xxiaolove8/engineering_innovation/docs/2026929PINOUT.md

# STM32F407 小车 PINOUT V3.1（同学验收版）

日期：2026-09-29。用途：载板原理图、PCB数字焊盘、线束和软件配置共用基线。

冻结范围：本版24根信号及接口数字脚号。**接线复核通过，不等于整机电气、机械或投板验收通过。** 任何后续改线须同步更新本文件与软件。

## 0. 工程版本、已确认项与边界

本版对应用户上传的 `NEWESTProPrj_工创分散实训小车主控板_2026-09-29.epro2`，大小252161字节，工程编辑器版本4.1.60。

SHA256：`523AC0C17B9F0D428ABD6AA84F86723254952C9E43B3041C24CF4AD324DDE7A5`。

已独立读取该工程的符号、数字引脚、封装、导线和网络属性：24根信号端点均与本表一致；23个实际元件的数字引脚集合与关联封装焊盘集合匹配；主要电源网未发现意外合并。这是源数据复核，不是由助手重新运行EDA内置DRC。详情见《最新工程审核_2026-09-29.md》。

用户提供的23:09:28 DRC为：致命错误0、错误0、警告8。此后仅口头说明“改好了”的修改不自动算作已审核；验收时应以新导出的工程和DRC记录为准。

本版确认：

- GRAY_OUT已从PF3 / H1-46改到PC5 / H1-16；旧PF3端点已标不连接，不是待实施建议。
- H1-3 / RESET没有接地，并标不连接。
- GPIO功能放在“引脚名称”，数字1、2……放在“引脚编号”，与PCB焊盘一致。网络名称仍由实际导线/网络标签定义，不能只靠普通文字。
- 蓝牙PB10=H2-28、PB11=H2-29。不得沿用旧稿错误的26/27号。
- 三路Echo维持直连，不把10kΩ/15kΩ分压或灰度转换芯片列为强制新增器件；电平条件见第5节。
- 现有入口10µF不等于舵机储能设计已验收；详细待办见《待研究与同学验收清单.md》。

可以进入PCB初步布局；在电源预算、接口实物方向等关键条件未确认前，不作为投板批准。V3.0原文留存在work目录；旧接线步骤只用于追溯，当前接线以本文件为准。

## 1. 依据和约定

1. 主控连线/排针号唯一依据：用户《ATK-DNM144Z-M4 STM32F407版_V1.0.pdf》，STM32F407ZGT6，M144Z-M4.PrjPCB V1.0。第1页核对PC5，第2页核对JP1/JP2、SRAM、Camera，第3页核对USB/电源。
2. GPIO复用/电气：ST DS8626。该手册不能代替实际核心板排针图。
3. 灰度：用户ZIP中的《8路灰度模块简介》《数据读取》《小车巡线》。数字扫描成立，但资料没有完整VOH/VOL/VIH/VIL保证表。
4. 超声波：用户《超声波模块手册HC-SR04-P…pdf》。实物须对应此型号；手册照片本身也只印HC-SR04，不能仅凭正面丝印区分版本。
5. D24A：用户两张商品接口/尺寸图；四路TB6612带稳压，只用A/B。J7数字针号是载板定义，不是商品图中的厂家针号。
6. ROS参考板：仅借鉴电源分区、去耦、接口整理；它是F103裸芯片设计，不用于决定本板引脚。其R4/R5属于PWRADC电源采样，不是Echo分压。

H1对应官方JP1，H2对应JP2。表格是符号/焊盘编号，不是实物某一面目视左右。A电机暂定左，B电机暂定右，安装/调试确认正方向。

## 2. 主控24根信号表（已按上传工程核对）

方向以MCU为准；O=输出，I=输入。A电机暂定左，B电机暂定右；实际转向和编码器正负号由调试确认。

| 功能 | 网络标签 | GPIO | 载板脚号 | 软件功能 | 方向 | 外设端点 |
|---|---|---|---|---|---|---|
| 左电机PWM | DRV_PWMA | PA2 | H1-8 | TIM5_CH3 / AF2 | O | J7-4 / PWMA |
| 右电机PWM | DRV_PWMB | PA3 | H1-9 | TIM5_CH4 / AF2 | O | J7-3 / PWMB |
| 左方向1 | DRV_AIN1 | PC0 | H2-15 | GPIO Output | O | J7-8 / AIN1 |
| 左方向2 | DRV_AIN2 | PC1 | H2-16 | GPIO Output | O | J7-6 / AIN2 |
| 右方向1 | DRV_BIN1 | PC2 | H1-10 | GPIO Output | O | J7-7 / BIN1 |
| 右方向2 | DRV_BIN2 | PC3 | H1-7 | GPIO Output | O | J7-5 / BIN2 |
| 驱动使能 | DRV_STBY | PC4 | H1-13 | GPIO Output，初始化低 | O | J7-2 / STBY |
| 左编码器A相 | ENC_L_A | PC6 | H2-50 | TIM3_CH1 / AF2 | I | J7-10 / E1A |
| 左编码器B相 | ENC_L_B | PC7 | H2-49 | TIM3_CH2 / AF2 | I | J7-12 / E1B |
| 右编码器A相 | ENC_R_A | PB6 | H2-32 | TIM4_CH1 / AF2 | I | J7-9 / E2A |
| 右编码器B相 | ENC_R_B | PB7 | H2-19 | TIM4_CH2 / AF2 | I | J7-11 / E2B |
| 舵机PWM | SERVO_PWM | PE9 | H1-36 | TIM1_CH1 / AF1 | O | J1-3 / PWM |
| 蓝牙发送 | UART3_TX | PB10 | H2-28 | USART3_TX / AF7 | O | J3-2 / 模块RX |
| 蓝牙接收 | UART3_RX | PB11 | H2-29 | USART3_RX / AF7 | I | J3-3 / 模块TX |
| 灰度地址最低位 | GRAY_AD0 | PF0 | H1-47 | GPIO Output | O | J2-3 / AD0 |
| 灰度地址中间位 | GRAY_AD1 | PF1 | H1-48 | GPIO Output | O | J2-4 / AD1 |
| 灰度地址最高位 | GRAY_AD2 | PF2 | H1-45 | GPIO Output | O | J2-5 / AD2 |
| 灰度数字输入 | GRAY_OUT | PC5 | H1-16 | GPIO Input / No Pull，不用ADC | I | J2-2 / OUT，直连 |
| 左超声波触发 | US_L_TRIG | PA1 | H1-5 | GPIO Output，初始化低 | O | J4-2 / TRIG |
| 左超声波回波 | US_L_ECHO | PF6 | H1-21 | TIM10_CH1 / AF3 / No Pull | I | J4-3 / ECHO，直连 |
| 中超声波触发 | US_C_TRIG | PA5 | H1-11 | GPIO Output，初始化低 | O | J5-2 / TRIG |
| 中超声波回波 | US_C_ECHO | PF7 | H1-22 | TIM11_CH1 / AF3 / No Pull | I | J5-3 / ECHO，直连 |
| 右超声波触发 | US_R_TRIG | PA7 | H1-14 | GPIO Output，初始化低 | O | J6-2 / TRIG |
| 右超声波回波 | US_R_ECHO | PF8 | H1-19 | TIM13_CH1 / AF9 / No Pull | I | J6-3 / ECHO，直连 |

PC5只作数字输入，不同时启用ADC12_IN15/ETH。已核对GRAY_OUT只连接H1-16与J2-2，H1-46不在该网络。数字脚号属于载板连接器，不是STM32芯片封装管脚号。

## 3. 电源、复位、保留脚及板载资源

| 脚号 | 官方定义 | 本设计接法 |
|---|---|---|
| H1-1 | GND | 公共地 |
| H1-2、H1-4 | VCC3.3 | 载板+3.3V，来自核心板，不并联D24A另一3.3V输出 |
| H1-3 | RESET | 已与GND断开，当前载板端点标不连接 |
| H1-6 | VREF | 保留不接，不当普通供电脚 |
| H1-46 | PF3 / SRAM A3 | 已不接灰度OUT，载板端点标不连接 |
| H2-1、H2-3 | VCC5 | 载板+5V |
| H2-2、H2-4 | GND | 公共地 |
| H2-5 | VBAT | 当前不接 |
| H2-20 | PG10 / SRAM CE | 载板不外接；软件确保核心板SRAM未选中 |

板载SRAM U2=XM8A51216V33A，3.3V供电。官方R1=10kΩ上拉CE；PE9共用D6，PF0/PF1/PF2共用A0/A1/A2。软件不启用FSMC/外部SRAM，先确保PG10高，再配置舵机与灰度。不插LCD。

OUT改PC5是为了避开PF3/SRAM A3共线。缺少模块OUT与SRAM输入耐压保证时，不能仅凭MCU的FT标记给整个共用网络验收；不声称已经证明原PF3一定损坏。

PC6/PC7/PB6/PB7还引到Camera：不插摄像头/其他外部驱动模块，不启用DCMI。其余板载Flash/TF/LED等资源脚不新增为本版信号。PA0未引到这两个50针接口，不占用。

## 4. 全部外设连接器

### J7：D24A A/B控制、编码器，2×6

| J7脚号 | 功能 | 网络 |
|---:|---|---|
| 1 | 3V3 | 不接，避免并联稳压输出 |
| 2 | STBY | DRV_STBY |
| 3 | PWMB | DRV_PWMB |
| 4 | PWMA | DRV_PWMA |
| 5 | BIN2 | DRV_BIN2 |
| 6 | AIN2 | DRV_AIN2 |
| 7 | BIN1 | DRV_BIN1 |
| 8 | AIN1 | DRV_AIN1 |
| 9 | E2A | ENC_R_A |
| 10 | E1A | ENC_L_A |
| 11 | E2B | ENC_R_B |
| 12 | E1B | ENC_L_B |

商品图元件面朝上、开关在上，六行左/右依次为3V3/STBY、PWMB/PWMA、BIN2/AIN2、BIN1/AIN1、E2A/E1A、E2B/E1B。插接面方向另核对，不能把焊接面左右当元件面左右。

J8-1/2均为GND，通过实际线束共地；J7没有GND，不能省略实际地回路。电机接D24A Motor A/B匹配的六针接口，C/D不用。

### J1、J2、J3

| 接口 | 数字脚号与定义 |
|---|---|
| J1舵机 | 1=GND；2=+5V；3=SERVO_PWM |
| J2灰度 | 1=GND；2=GRAY_OUT；3=GRAY_AD0；4=GRAY_AD1；5=GRAY_AD2；6=+5V |
| J3六针蓝牙底板 | 1=STATE不接；2=RX接UART3_TX；3=TX接UART3_RX；4=GND；5=+5V；6=3V3不接 |

J3的5V只适用于确认支持5V供电的六针底板，不能用于裸模块。J1供电和峰值电流按实际舵机规格确认。

### J4、J5、J6：本版维持当前5V供电/直连

| 脚号 | J4左 | J5中 | J6右 |
|---:|---|---|---|
| 1 | +5V | +5V | +5V |
| 2 | US_L_TRIG | US_C_TRIG | US_R_TRIG |
| 3 | US_L_ECHO | US_C_ECHO | US_R_ECHO |
| 4 | GND | GND | GND |

不需要RAW标签或旧六只分压电阻。不擅自改供电为3.3V。若以后选P版3.3V供电，须同步改电源线、符号脚名/丝印与去耦电源网，不是只改文字；GPIO仍不变。

### 电源和备用驱动

- J13 POWER_IN：1=+5V，2=GND，是稳压后5V输入，不接电池原电压。
- J14 MOTOR_PWR_IN：1=5V_MOTOR，2=GND；只通备用TB6612 VM，不是D24A Vin/降压模块。
- J9：1=VM/5V_MOTOR；2=VCC/+3.3V；3=GND；4=AO1/MOTORLA；5=AO2/MOTORLB；6=BO2/MOTORRB；7=BO1/MOTORRA；8=GND。
- J10：1=DRV_PWMA；2=DRV_AIN2；3=DRV_AIN1；4=DRV_STBY；5=DRV_BIN1；6=DRV_BIN2；7=DRV_PWMB；8=GND。
- J11：1=MOTORLA，2=MOTORLB；J12：1=MOTORRA，2=MOTORRB。

本版保留备用接口，不擅自删图；默认只用D24A，备用TB6612模块未插、J14未供电。两个驱动不接同一电机；切换先断电。不要长期插着备用模块却不给它供电，以免控制线经其内部路径反供电。

## 5. 电平依据及验收

### Echo

P版手册允许3.0~5.5V供电，但未给5V供电时Echo VOH/VOL、Trig VIH/VIL。不能认定Echo必为5V或必为3.3V，低压直连说明也不等于5V供电时固定3.3V输出。

PF6/7/8在ST表7均为FT。核心板正常3.3V供电、数字/定时器输入、No Pull、不启用模拟功能且满足ST数据手册条件时，可接收符合条件的3.3V或5V数字电平，因此本版不强制分压。ST DS8626表14在VDD为2.0～3.6V时给出FT输入工作范围−0.3～5.5V，并要求输入高于VDD+0.3V时禁用内部上/下拉；设计不能把边界值当作过冲余量。调试核验Echo高低电平/过冲及3.3V Trig触发可靠性，不把万用表脉冲平均值当峰值。

若原Echo为3.3V，旧10k/15k会降到1.98V，缩小高电平余量。FT不是噪声、掉电或接错线的全面保护；外设不得独立上电后持续向掉电核心板送信号，不带电插拔。

### 灰度

模块按手册供5V；AD0/1/2选择CD4051通道，OUT数字输出，EN已有10kΩ下拉。配套F103教程用3.3V推挽输出PA0/1/2直接驱动地址、PA3直接读OUT；配套小车教程也是5V模块与STM32直接接线。这是供应商应用依据，不是完整最坏条件保证表。

本版PF0/1/2直接输出地址，PC5 FT数字输入/No Pull读取OUT。不要在地址线上分压；不默认增加升压或输出缓冲芯片；不用ADC。

AD2 AD1 AD0：000→CH1，001→CH2，…，111→CH8；切换后按例程先等待50µs。黑白对应按实物校验。核对实际CD4051门限与3.3V地址输出裕量，并实测全部8通道选通和OUT电平；依据规格与测试决定是否需要转换，不盲加器件，也不把单次试通当作最坏条件保证。

## 6. 定时器、软件约束

| 用途 | 资源 | 约束 |
|---|---|---|
| 电机两路PWM | TIM5 CH3/CH4 / AF2 | 同频，占空比独立 |
| 左编码器 | TIM3 CH1/CH2 / AF2 | 编码器模式 |
| 右编码器 | TIM4 CH1/CH2 / AF2 | 编码器模式 |
| 舵机 | TIM1 CH1 / AF1 | 周期/脉宽按实物，不直接冻结50Hz |
| 左/中/右Echo | TIM10 CH1 AF3 / TIM11 CH1 AF3 / TIM13 CH1 AF9 | 单通道16位捕获，边沿配对、超时和回绕 |
| 蓝牙 | USART3 / AF7 | 波特率按模块 |
| 灰度 | PF0/1/2输出，PC5输入 | 数字扫描 |

TIM10与TIM1更新共享TIM1_UP_TIM10；TIM11与TIM1触发/换相共享TIM1_TRG_COM_TIM11；TIM13与TIM8更新共享TIM8_UP_TIM13。中断内区分事件，不照搬双通道PWM Input例程。分频依据真实APB定时器时钟。三路探头轮流触发，不同时发射。

先确保PG10高、FSMC/DCMI不用；STBY/TRIG保持低；配置方向/PWM/捕获/UART/灰度，再按需使能电机。GRAY_OUT使用GPIOC Pin5并开启GPIOC时钟，逻辑名保持不变。复位/程序下载期间STBY是否可靠为低仍须核对D24A板上的上下拉与硬件默认状态，不能只靠程序运行后拉低。

## 7. 电源、现有电容与验收状态

电池→D24A Vin；D24A 5V/GND→J13→载板+5V/GND→核心板/5V外设。电池匹配电机与模块额定范围；商品输入5.5～15V、输出5V 5A只是商品标称，不是实际峰值能力和热余量测试结论。

核心板USB_5V经F1直接连VCC5，未画电源择一路径；保险丝不隔离回灌。当前普通USB供电与外部5V二选一。外供电下使用SWD时，确认调试器不另外输出供电；Vref检测脚和电源输出脚不能混淆。若要USB和外部电源同时连接，必须另行审核真实电源会合路径。

### 已上传工程实际放置的7只电容

| 位号 | 容量与型号 | 电源与位置用途 |
|---|---|---|
| C1 | 100nF，GCM31C5C1H104FA16L，1206 / 50V / C0G | J13入口去耦，跨+5V与GND |
| C2 | 同上，100nF | 灰度J2供电去耦 |
| C3 | 同上，100nF | 蓝牙J3供电去耦 |
| C7、C9、C10 | 同上，各100nF | 三路超声波J4/J5/J6供电去耦 |
| C12 | 10µF，CL21A106KAYNNNE，0805 / 25V / X5R | J13入口，跨+5V与GND |

位号和电气连接已核对；“位置”表示原理图功能分组，PCB上仍需实际靠近对应接口。未使用的库内电阻、电容不计入实际BOM。

当前**没有J1舵机接口专用的本地储能电容**。C12不是已定型的舵机储能方案；容量、耐压、ESR、纹波电流、封装、位置及稳压器兼容性仍待选择和验证。不能直接宣布应加某个固定容量，也不能认为电容越大越好。

### 尚待完成

模块电平/门限及上电顺序、舵机与电源峰值预算、USB使用方案、核心板与模块机械适配、BOM整理、软件初始化与PCB设计验收。按《待研究与同学验收清单.md》逐项记录证据与结论。

## 8. 技术链接

- [ST数据手册：引脚、复用、工作条件](https://www.st.com/resource/en/datasheet/stm32f407zg.pdf)
- [ST官方CMSIS：中断定义](https://github.com/STMicroelectronics/cmsis-device-f4/blob/master/Include/stm32f407xx.h)
- [嘉立创专业版：网络标签](https://prodocs.lceda.cn/cn/schematic/place-net-label/)
- [嘉立创专业版：原理图规则](https://prodocs.lceda.cn/cn/schematic/design-design-rule/)

不使用其他型号核心板的排针表，也不以普通HC-SR04参数覆盖用户新提供的P版手册。

## 9. H1/H2完整数字脚号索引

以下依据ATK官方V1.0第2页。仅表示电气编号关系，不表示实物朝向；PCB/线束必须另外标Pin1并核对插接面。未在24根信号表中使用的GPIO不得自行占用，先检查核心板内部共用资源。

| 奇数脚号 | H1 / JP1 | H2 / JP2 | 偶数脚号 | H1 / JP1 | H2 / JP2 |
|---:|---|---|---:|---|---|
| 1 | GND | VCC5 | 2 | VCC3.3 | GND |
| 3 | RESET | VCC5 | 4 | VCC3.3 | GND |
| 5 | PA1 | VBAT | 6 | VREF | PB4 |
| 7 | PC3 | PG14 | 8 | PA2 | PG13 |
| 9 | PA3 | PG12 | 10 | PC2 | PG11 |
| 11 | PA5 | PE3 | 12 | PA4 | PE2 |
| 13 | PC4 | PE5 | 14 | PA7 | PE6 |
| 15 | PB0 | PC0 | 16 | PC5 | PC1 |
| 17 | PB2 | PE1 | 18 | PB1 | PE0 |
| 19 | PF8 | PB7 | 20 | PF11 | PG10 |
| 21 | PF6 | PG9 | 22 | PF7 | PD5 |
| 23 | PB13 | PD4 | 24 | PB12 | PD3 |
| 25 | PD11 | PD1 | 26 | PF5 | PD0 |
| 27 | PD13 | PA15 | 28 | PD12 | PB10 |
| 29 | PE11 | PB11 | 30 | PF13 | PB3 |
| 31 | PE12 | PB5 | 32 | PE10 | PB6 |
| 33 | PE14 | PA6 | 34 | PE13 | PA12 |
| 35 | PE8 | PA11 | 36 | PE9 | PG8 |
| 37 | PD15 | PG7 | 38 | PE7 | PG6 |
| 39 | PD14 | PC9 | 40 | PE15 | PC8 |
| 41 | PD9 | PA8 | 42 | PD8 | PC12 |
| 43 | PF4 | PD2 | 44 | PD10 | PC11 |
| 45 | PF2 | PC10 | 46 | PF3 | PG15 |
| 47 | PF0 | PD7 | 48 | PF1 | PD6 |
| 49 | PB15 | PC7 | 50 | PF12 | PC6 |

## 10. 同学验收记录

接线/引脚复核：________；电源与储能复核：________；机械/封装复核：________；软件资源复核：________。

验收所用工程文件名、日期及SHA256：________。

结论：□ 接线基线通过　□ 有条件通过（列出条件）　□ 需修改。整机通电与PCB制造验收另行记录，不凭原理图DRC 0错误直接签通过。
