xxiaolove8/engineering_innovation/docs/REVIEW_2026-09-30.md

# 资料对照与工程重构审查（2026-09-30）

本记录是首次重构时的审查。后续已收到四针 JDY-31 和八路灰度官方 PDF/RAR 并更新工程；当前模块适配、500 µs 采样等待、LINE? 诊断及验证结果见 [MODULE_UPDATE_2026-09-30.md](MODULE_UPDATE_2026-09-30.md)。原文中的灰度资料缺失和 BT24 配置仅反映当时状态。

本次以 `2026929PINOUT.md` V3.1 为接线基线，检查归档的 7 个资料文件，并审查现有固件、上位机、IOC、CSV、PID 固化区和测试。保留开始本次任务时已有的未提交 PID/控制逻辑/上位机工作。

同日收到“超声波没有信号”反馈后继续检查，取消了无上升沿时返回有效 6000 mm 的行为，并加入原始诊断和延时故障保护。以下验证数字记录首次重构；后续变更与最新验证结果见 [超声波联调记录](ULTRASONIC_CHECK_2026-09-30.md)。

## 已修正的差异

| 项目 | 原工程 | 本次结果 |
| --- | --- | --- |
| 左/右电机 PWM | TIM3 CH1/CH2，PC6/PC7 | TIM5 CH3/CH4，PA2/PA3，20 kHz。 |
| 方向与 STBY | PD0–PD4 | PC0–PC4，STBY 初始低；换向前关使能并提交零占空比。 |
| 左编码器 | TIM2，PA0/PA1，32 位 | TIM3，PC6/PC7，16 位；两轮均按 16 位有符号差分处理回绕。 |
| 灰度 | 六路、PF3 OUT、20 µs | 八路、PC5 OUT、50 µs。通道顺序与黑白极性集中标定。 |
| 超声波 | 两路，TIM9 CH1/CH2 | 左/中/右三路 TIM10/11/13 CH1，PA1/PA5/PA7 TRIG、PF6/PF7/PF8 ECHO。 |
| 捕获时钟与中断 | 共用 TIM9 | TIM10/11 PSC=167，TIM13 PSC=83，均 1 µs；三组共享向量分别处理相应外设。 |
| 核心板 SRAM 共用总线 | 没有主动禁止 SRAM | PG10 上电初始化最先拉高，FSMC/DCMI/ADC 均不启用。 |
| 舵机规格 | 型号未定、泛用 50 Hz | 对照 DS3218 支持范围，保留 50 Hz、1500 µs 中位和较窄机械范围；信号方向可标定。 |
| 蓝牙上位机 | 假定蓝牙对应 Windows COM | 增加 DX-BT24 BLE GATT；保留 USB-TTL COM 调试。UART 默认 9600 与手册一致。 |
| 遥测 | v1、六位灰度、两路距离 | v2 `PONG 2`、0–255 灰度、左/中/右三路距离。旧上位机/固件握手失败时释放连接。 |
| 测距失效 | 使用状态进入时间判断，所有超时均当无回波 | 独立从本次失效开始计时；卡高、缺下降沿、不合格脉宽判无效。新捕获期间保留前一有效值。 |
| 近距离障碍 | 0–30 mm 被排除；冷却和绕行阶段缺少前方保护 | 中路障碍参与选路；紧急前方距离/极近侧距/双侧受阻在每个运动状态都停机。 |
| 终点识别 | 避障计数 ≥4 才允许停止 | 离开起点全黑区域后按八路终点特征判定，不依赖绕障次数。 |
| UART 数据损坏 | 丢字节后仍可能拼接成命令 | 缓冲区溢出/串口错误后丢弃损坏片段，重新从行边界接收。 |
| 驱动命令解析 | `%d` 可能把超范围整数转换成小 PWM | 使用 `strtol` 检查溢出、分隔与边界，拒绝超范围命令。 |
| CPU 异常 | 进入死循环，PWM 可能持续输出 | NMI/HardFault/存储/总线/用法异常及初始化错误先关 STBY、清电机 PWM；不依赖已初始化的 HAL 句柄。 |
| PLLQ | 4，48 MHz 域实际为 84 MHz | 改为 7，使该时钟域为 48 MHz。CPU 仍为 HSI PLL 168 MHz，未推断实物 HSE 型号。 |

`PINOUT.md`、`if_car.ioc`、`pinout.csv`、`main.h`、MSP、初始化和中断均已同步。新增 `board_pinout.csv` 区分 H1/H2 数字脚号与芯片封装号，软件标定项集中在 `car_config.h`。保留 PID 参数结构、Flash sector 11 保留区与原有只允许 IDLE 修改参数的状态约束。

## 资料检查与适用边界

核心板 IO 表中 PC0–PC5/PF6–PF8 可独立使用，PC6/PC7/PB6/PB7 在不接 Camera 时可作普通 IO；PE9、PF0–PF2 与 SRAM 共用，PG10 为 SRAM CE。归档原理图和新版接线表中的所用排针关系相符。归档原理图的 SRAM 型号/文件版本并不完全等同 V3.1 引用的 ATK-DNM144Z-M4 资料，因此只采用已核对的共用资源关系，未宣布实物版本一致。

Echo 与灰度维持 V3.1 的直连/No Pull 方案。旧版通用 HC-SR04 强制分压、PF3 接灰度 OUT 的建议已撤出当前接线文件。完整电平保证、上电次序和触发门限需原模块手册及实测，不能用 STM32 单个引脚耐压结论替代整条网络验收。

DS3218 数据表第 1/2 页给出 4.8–6.8 V 电源范围；第 2/2 页给出 5 V 堵转 1.8 A、500–2500 µs、1500 µs 中位、50–330 Hz。当前 1300–1700 µs 是初始机械保护范围，不是该舵机额定全行程。

DX-BT24 技术手册电源表给出裸模块 VBAT 2.8–3.6 V、典型 3.3 V。AT 手册第 5 页给出 9600 8N1 与 FFE0/FFE1/FFE2，第 19–20 页说明通知/写入特征。6 针底板能否接 5 V 依赖实际底板稳压电路。AT 命令需在模块命令模式下另行设置；固件不在比赛期间改模块参数。

## 验证

运行 `python tests/run_tests.py`：三组本机 C 测试（控制/PID、Flash 记录、硬件/应用）与 Python 协议、BLE、引脚一致性测试。

新增回归包括三路轮询与错误定时器回调、16 位 Echo/编码器回绕、8 地址/50 µs 数字读取、卡高/缺下降沿/过期值、采样期间上一结果保留、UART 溢出后行重同步、C 应用 v2 字段、中路障碍及全状态停机、终点不依赖计数、BLE 拆分通知/20 字节写入/FFE1 回退/失效会话/连接清理，以及归档表中全部 24 根信号与软件和 CSV/IOC 对照。

验证结果：**3 组 C 测试、16 项 Python 测试全部通过**；Debug/Release 交叉构建均通过，固件分别占 Flash 58,548 / 43,396 字节，RAM 4,016 / 3,968 字节（含链接脚本预留）。Tkinter 仿真连接、8 位灰度及中路距离显示/输入冒烟检查通过。7 个源资料的大小、SHA256 和原件逐字节比较均通过。

BLE 测试采用模拟 GATT 后端，尚未连接实物 DX-BT24；测试运行时未安装 Bleak，使用实物前按 README 安装依赖。源码和 IOC 的一致性检查不等同本次运行 CubeMX 图形界面重新生成。测距恢复后，绕障阶段会扣除因传感器失效而停止的时长，避免原地停等被当作完成绕行；回归用例已通过。

## 尚需实车验证

- 八路灰度的实际安装顺序、黑白极性、环境光影响、起终点全黑特征。
- 电机 A/B 安装方向、编码器极性/计数、舵机正方向、中位和机械限位。
- 三路探头方向、有效距离、3.3 V TRIG、Echo 峰值与串音。后续驱动将无回波判无效，不再视为空旷距离；超量程行为需要对照实际模块例程与手册。
- DS3218、D24A 与核心板峰值供电、共地、USB/外部 5 V 路径、复位/下载时 STBY 默认状态。
- 随机侧置障碍与赛段完成标识/计时门的区别。绕障时长仍是初始值；回线计数不证明无接触绕障，不能等同裁判得分。
- 终点特征仍含 10 s 最小时间和 20 ms 全黑保持假设，须结合阵列位置与制动距离确认满足比赛停止要求。
- 当前接线基线没有本地启动/实体急停信号；赛前预备后自主运行，正式比赛禁止远程干预。需要本地开关时须另确定硬件接线。
- V3.1 引用的灰度 ZIP、HC-SR04-P 手册、D24A 电路与载板 `.epro2` 未归档，未独立重新执行这些器件/PCB 的电气审查。
