xxiaolove8/engineering_innovation/docs/modules/line_sensor/troubleshooting.pdf

# 模块识别不良解决方案

模块识别不良解决方案
1.模块识别不良解决方案

# 1.模块识别不良解决方案

若在使用八路灰度巡线模块时出现识别效果不佳的情况，例如绿光款模块在白底上，无论是否对准目标颜色，部分探 头对应的指示灯始终常灭，此时可尝试将对应探头的发射管与接收管略微向外掰开。

例如模块X8指示灯在白底下始终常灭，可如下图所示向外掰开X8对应的发射管与接收管。

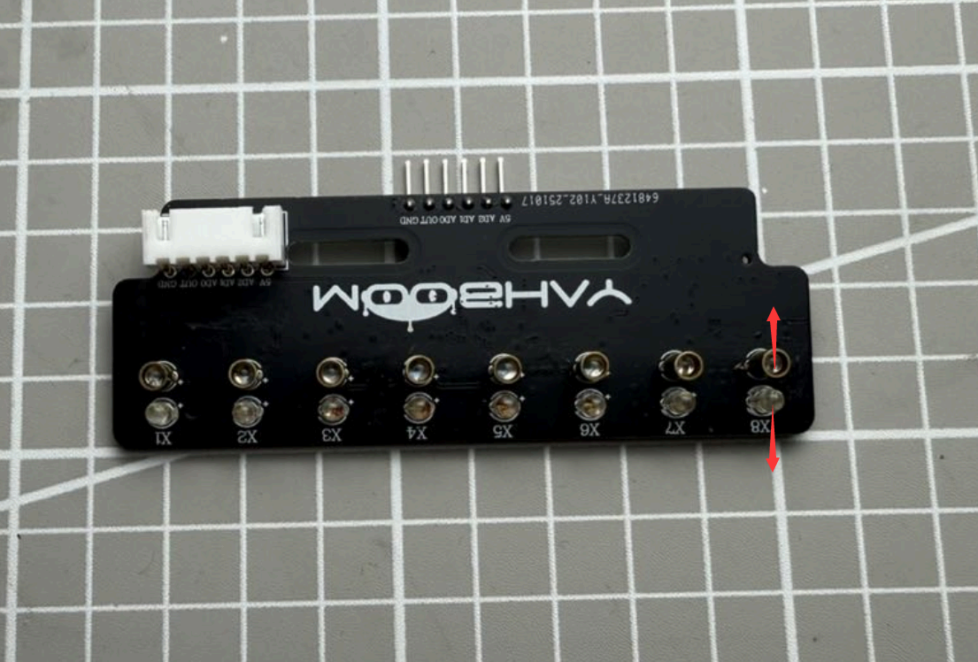
[picture p1: figure]

若在使用八路灰度巡线模块时出现识别效果不佳的情况，例如绿光款模块在黑底上，无论是否对准目标颜色，部分探 头对应的指示灯始终常亮，此时可尝试将对应探头的发射管与接收管略微向内挤压。

例如模块X8指示灯在黑底下始终常亮，可如下图所示向内挤压X8对应的发射管与接收管。

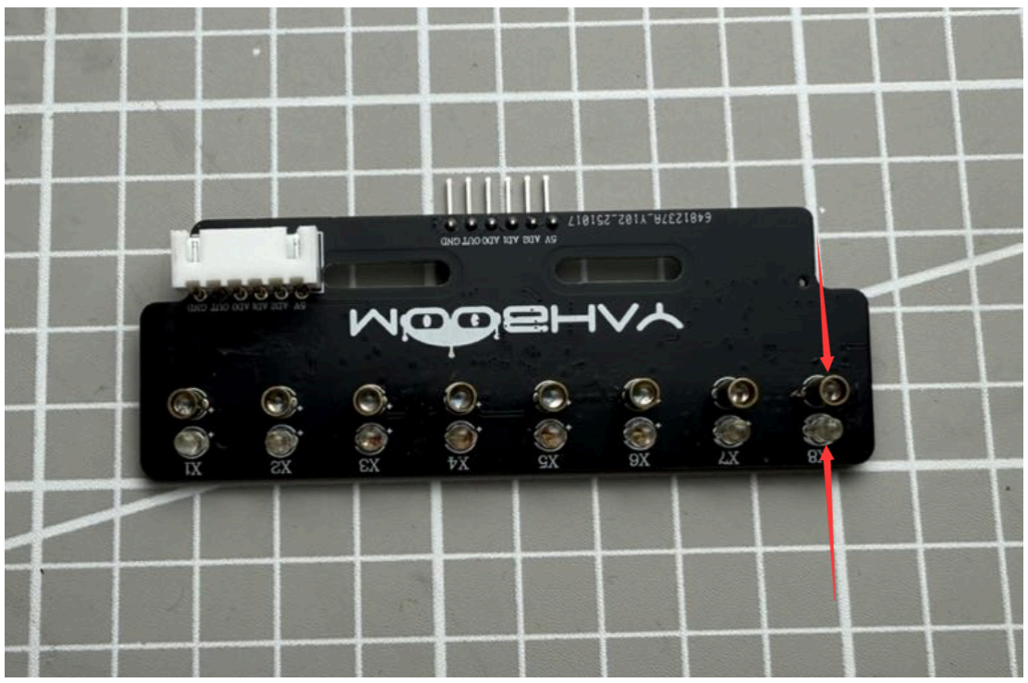
[picture p2: figure]
