xxiaolove8/engineering_innovation/docs/f407_data/STM32F407_CORE_BOARD_V1.4.pdf

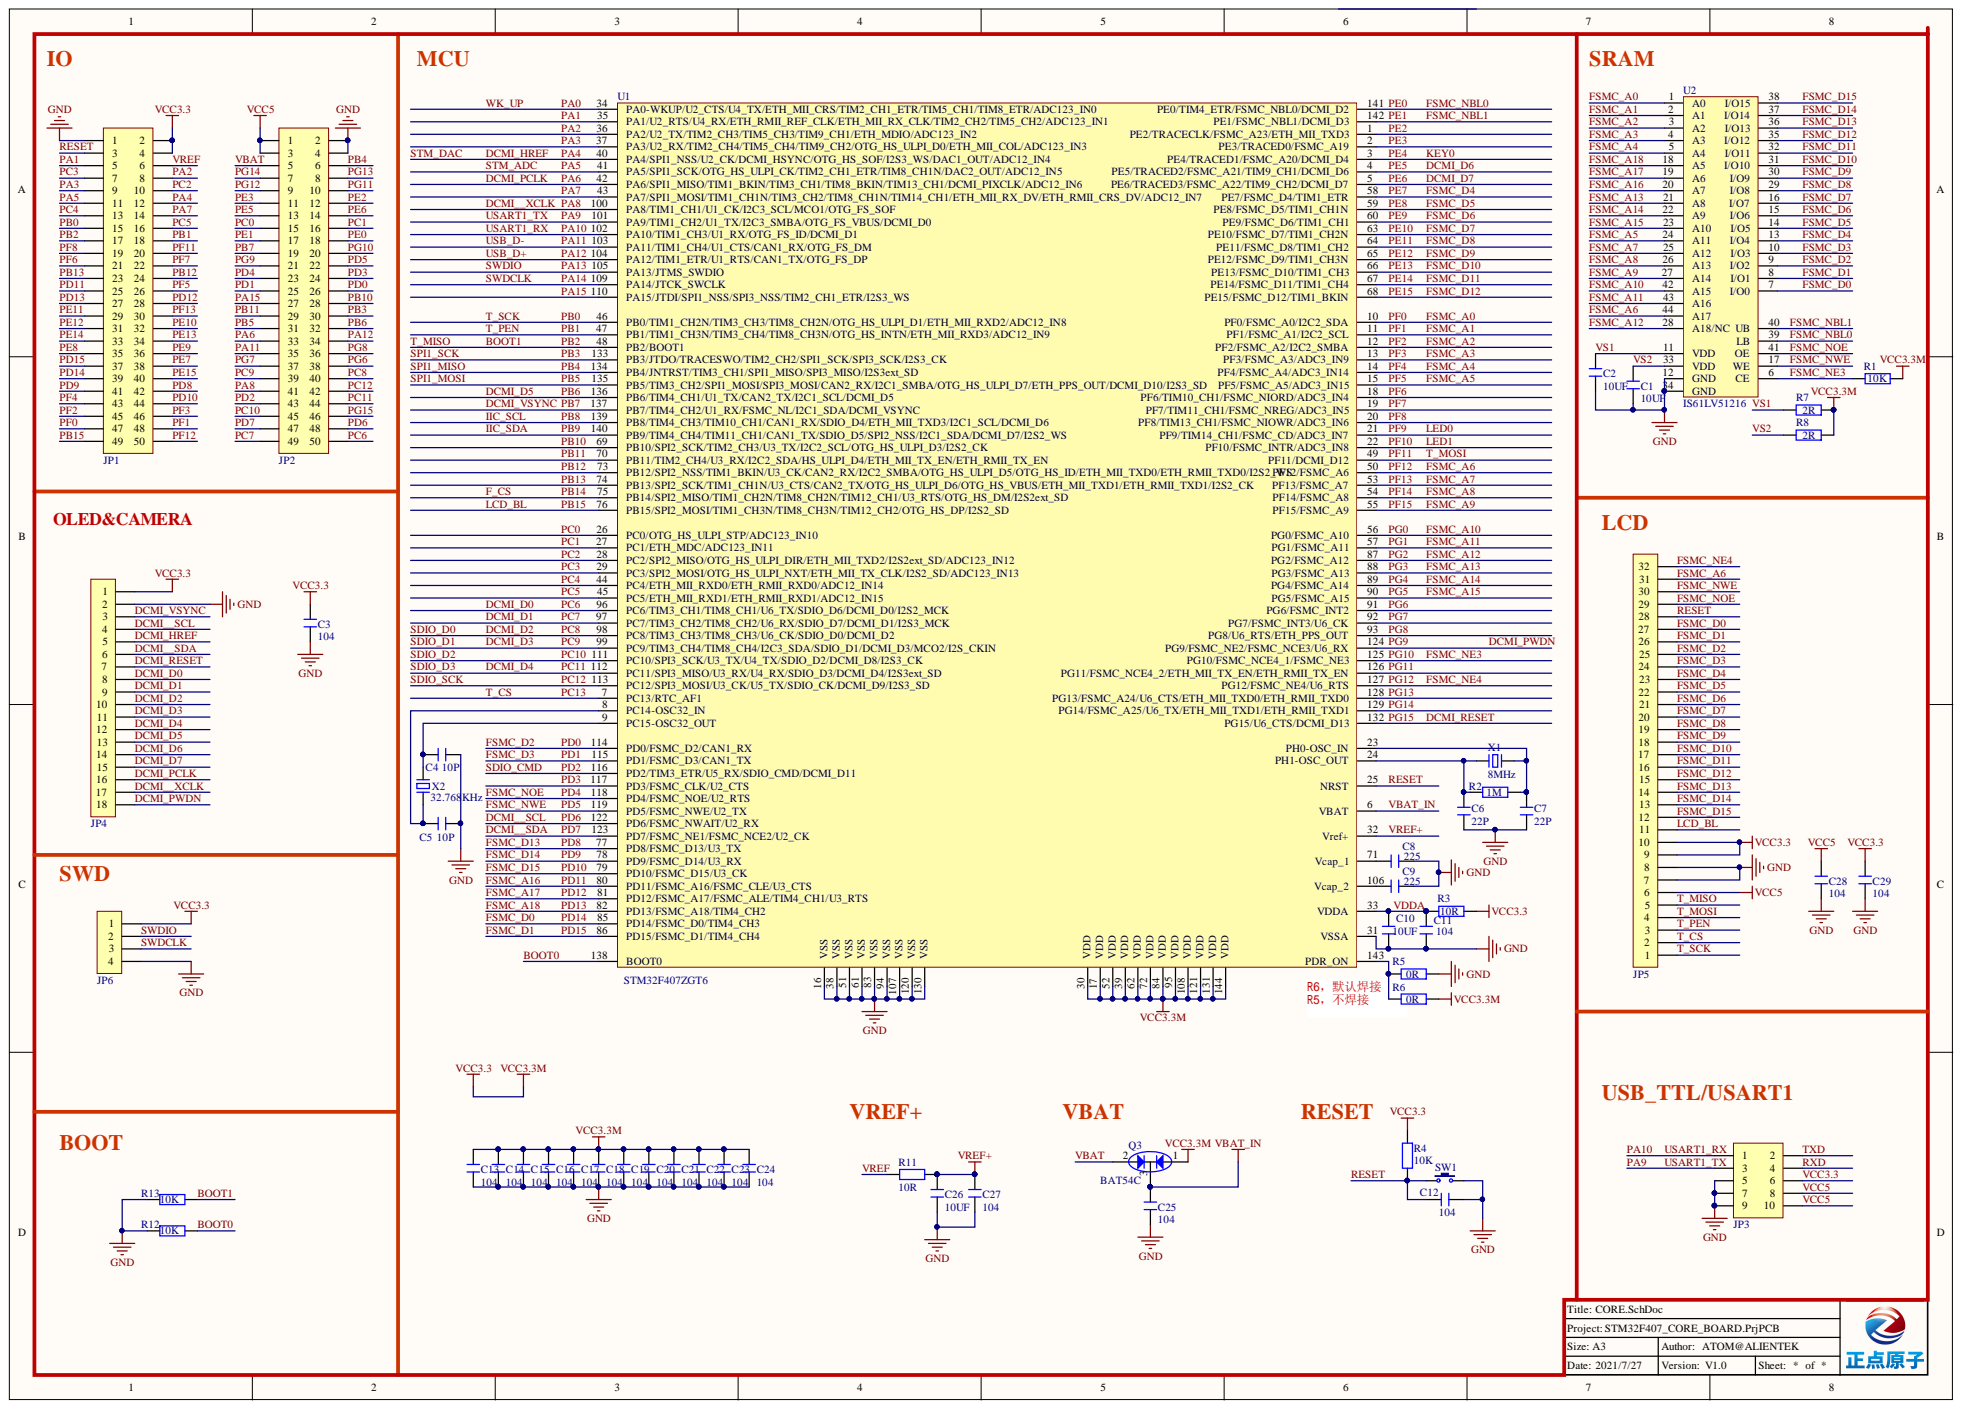
[picture p3: page 1]

BOOT

S i z e : A3 | Au th o r : ATOM @AL IENTE K

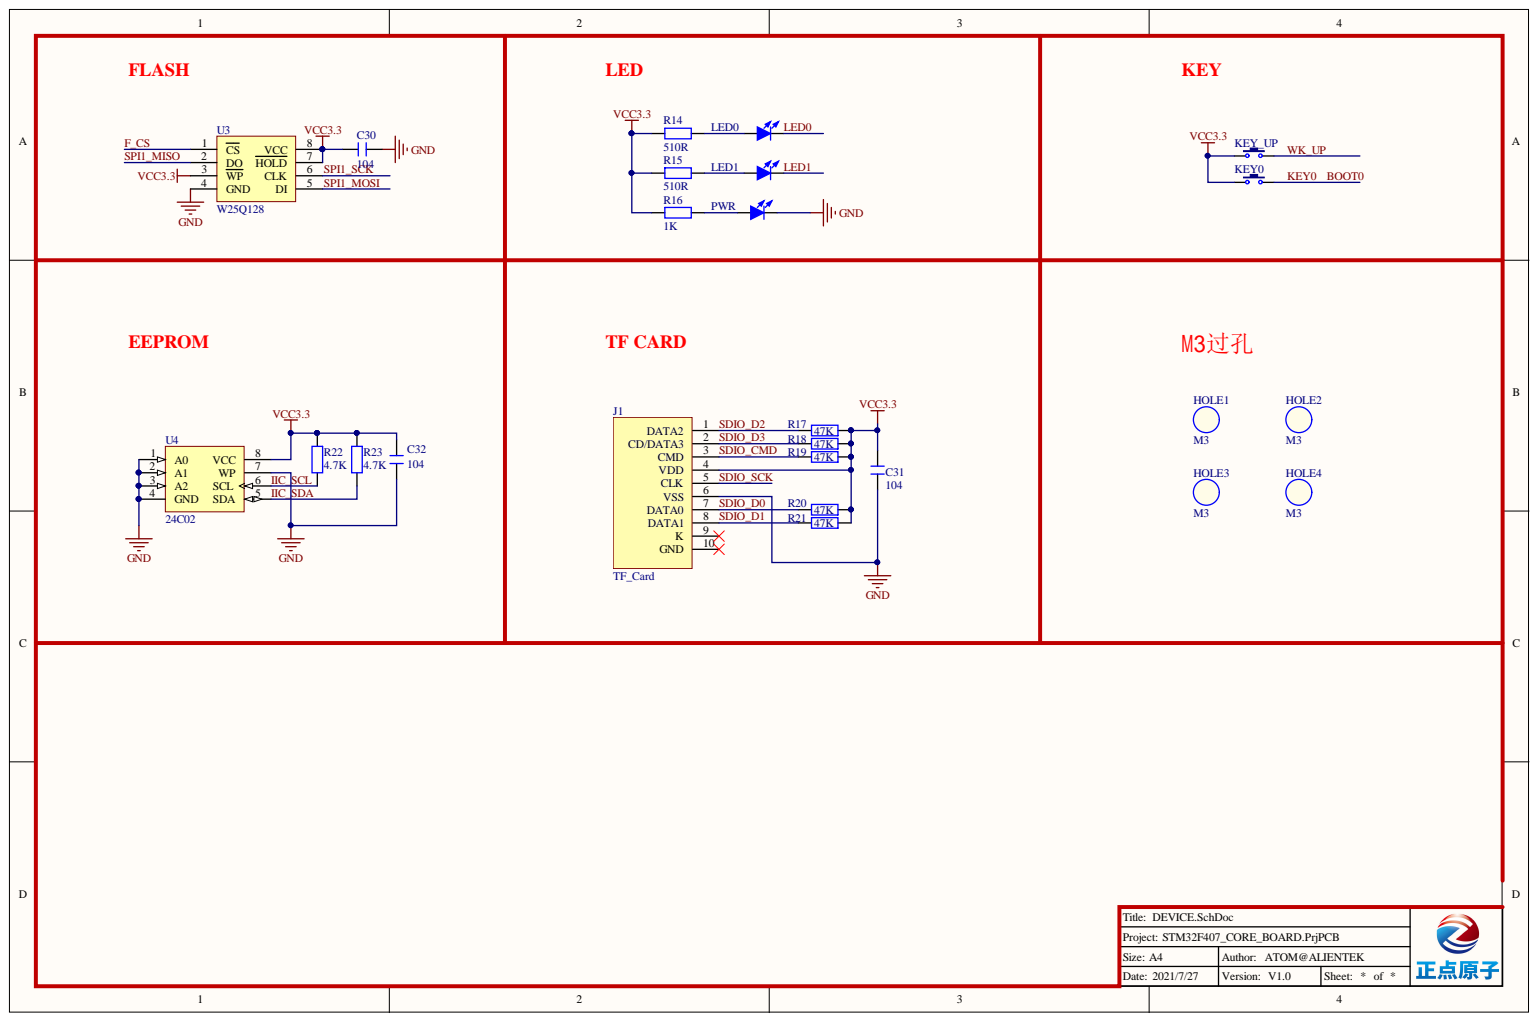
[picture p4: page 2]

Size: A4 | Author: ATOM@ALIENTEK
Date: 2021/7/27 | Version: V1.0 | Sheet: * of *

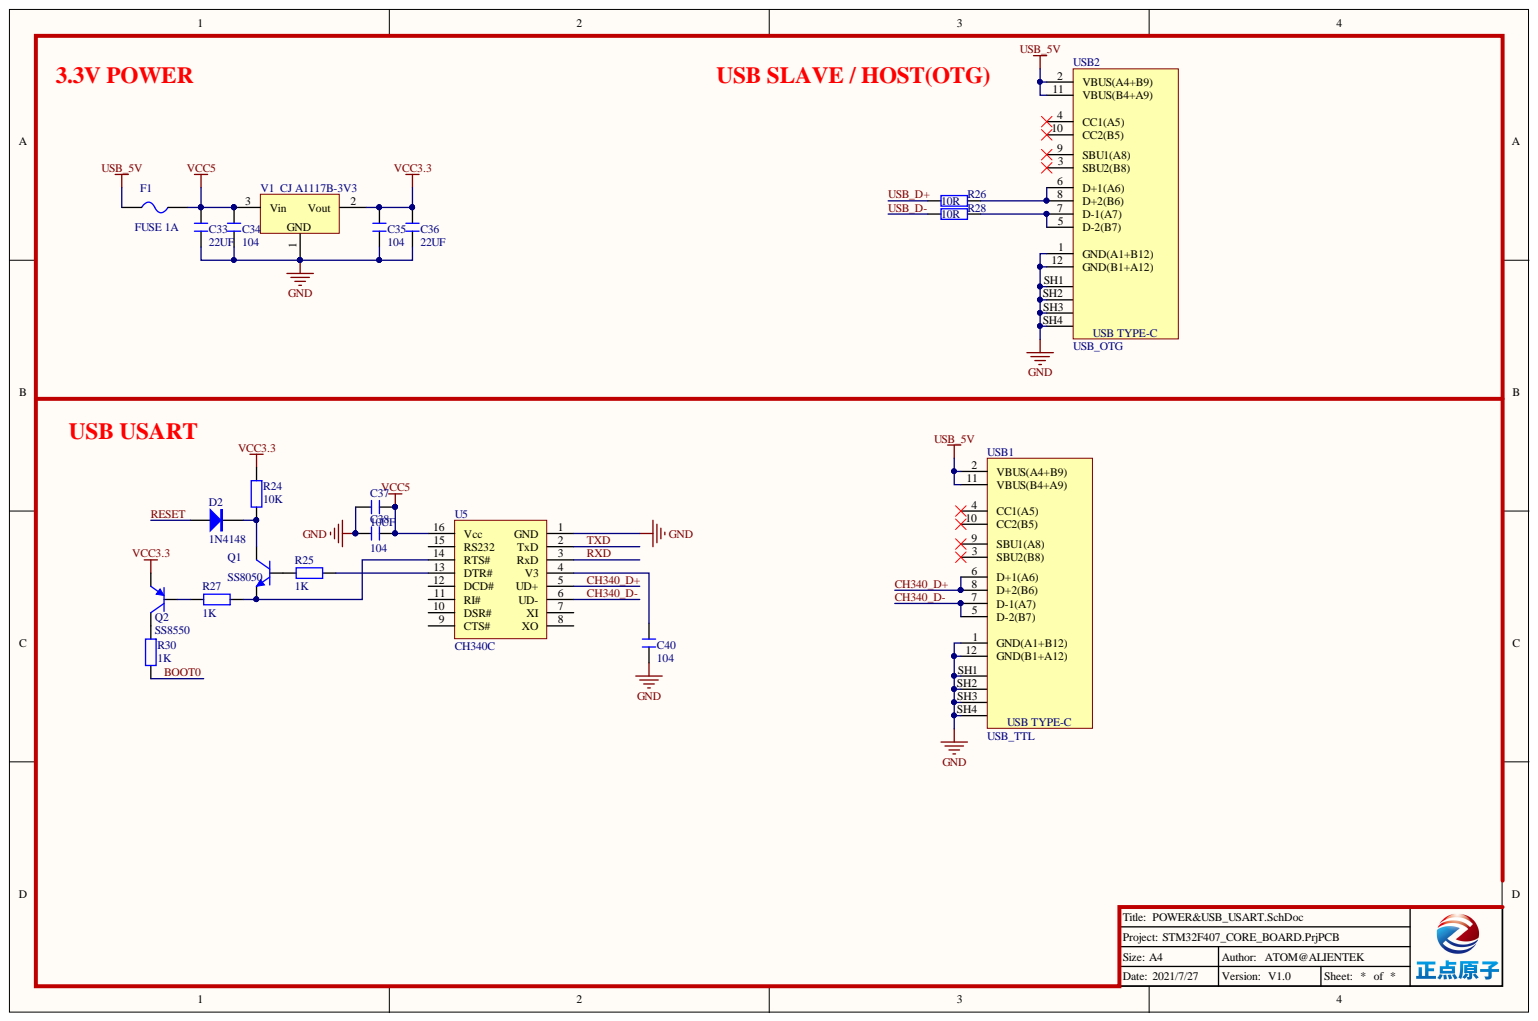
[picture p5: page 3]

USB_5V

USB SLAVE / HOST(OTG)

Size: A4 | Author: ATOM@ALIENTEK
Date: 2021/7/27 | Version: V1.0 | Sheet: * of *

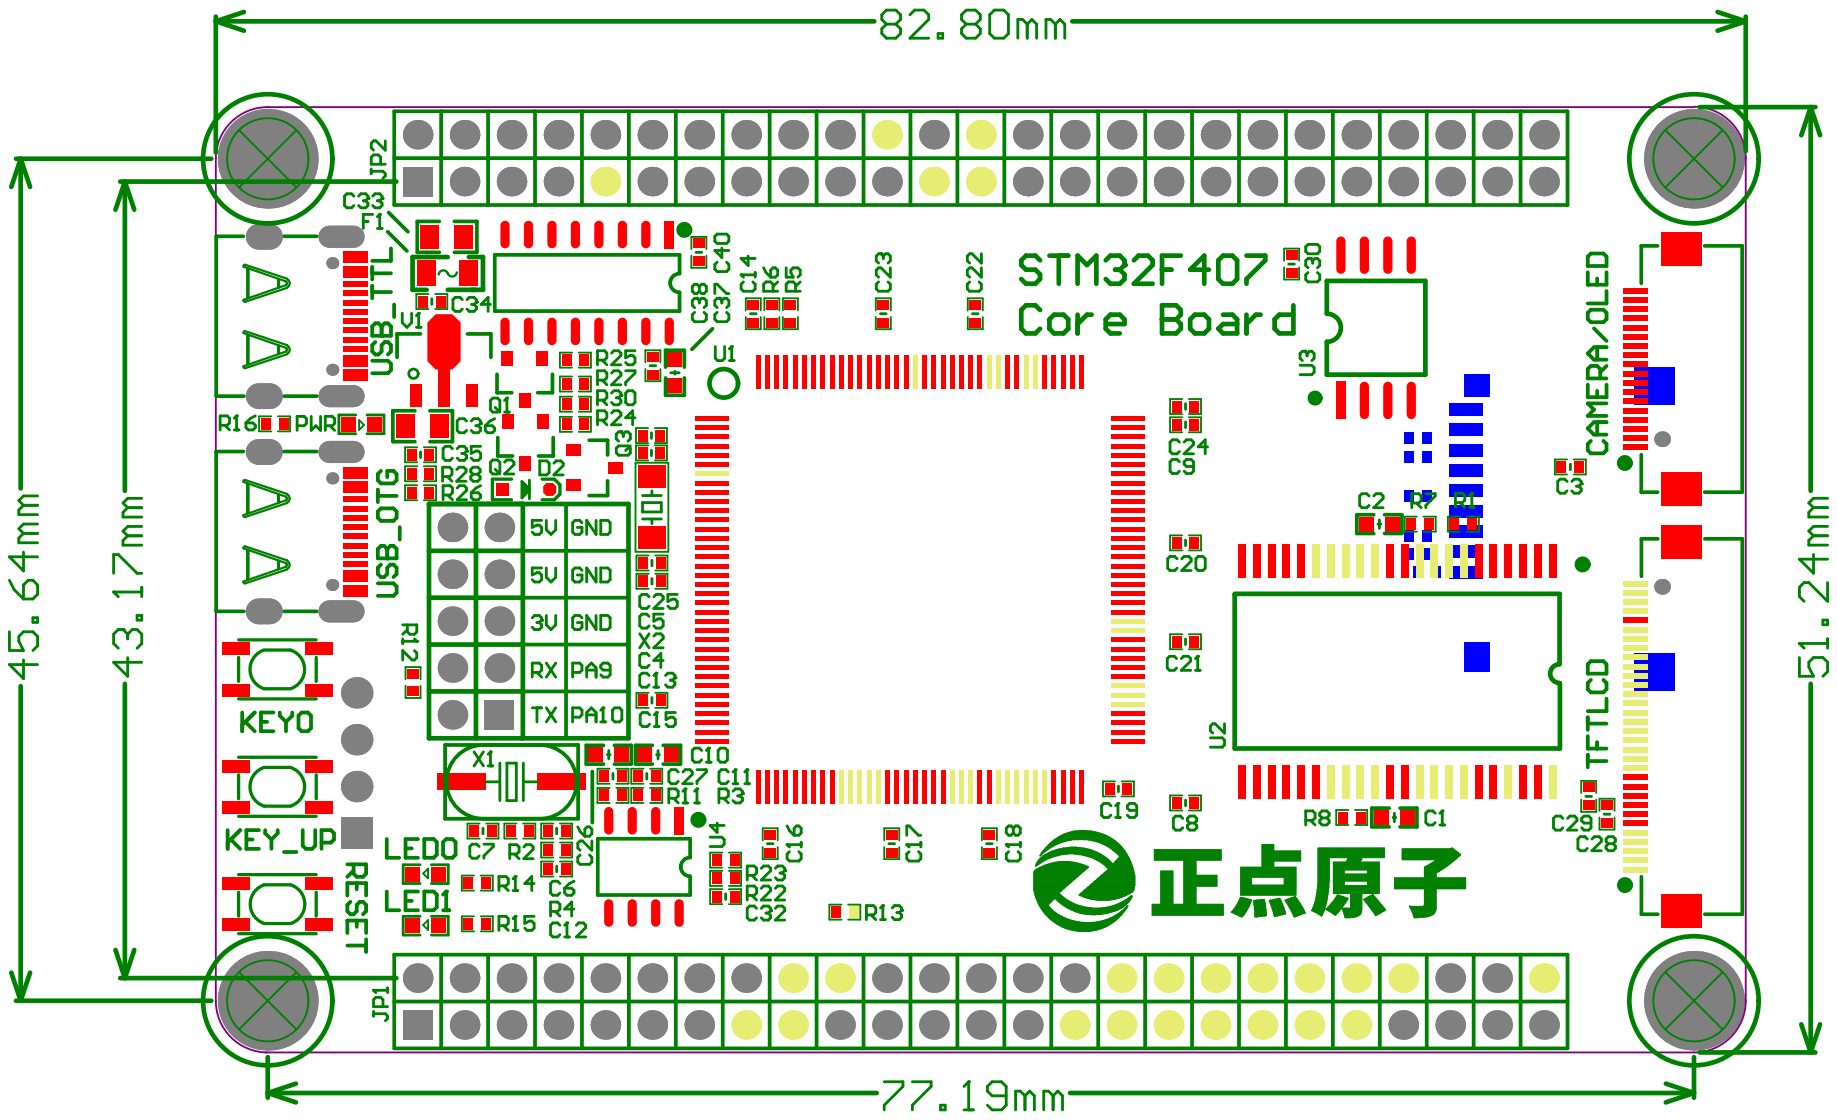
[picture p6: page 4]
