xxiaolove8/engineering_innovation/Core/Src/main.c

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
/* Includes ------------------------------------------------------------------*/
#include "main.h"

/* USER CODE BEGIN Includes */
#include "car_app.h"
#include "car_config.h"

/* USER CODE END Includes */

TIM_HandleTypeDef htim1;
TIM_HandleTypeDef htim3;
TIM_HandleTypeDef htim5;
TIM_HandleTypeDef htim4;
TIM_HandleTypeDef htim10;
TIM_HandleTypeDef htim11;
TIM_HandleTypeDef htim13;

UART_HandleTypeDef huart1;
UART_HandleTypeDef huart3;

void SystemClock_Config(void);
static void MX_GPIO_Init(void);
static void MX_TIM1_Init(void);
static void MX_TIM3_Init(void);
static void MX_TIM5_Init(void);
static void MX_TIM4_Init(void);
static void MX_TIM10_Init(void);
static void MX_TIM11_Init(void);
static void MX_TIM13_Init(void);
static void MX_USART1_UART_Init(void);
static void MX_USART3_UART_Init(void);
/**
  * @brief  The application entry point.
  * @retval int
  */
int main(void)
{

  /* MCU Configuration--------------------------------------------------------*/

  /* Reset of all peripherals, Initializes the Flash interface and the Systick. */
  HAL_Init();

  /* Configure the system clock */
  SystemClock_Config();

  /* Initialize all configured peripherals */
  MX_GPIO_Init();
  MX_TIM1_Init();
  MX_TIM3_Init();
  MX_TIM5_Init();
  MX_TIM4_Init();
  MX_TIM10_Init();
  MX_TIM11_Init();
  MX_TIM13_Init();
  MX_USART1_UART_Init();
  MX_USART3_UART_Init();
  /* USER CODE BEGIN 2 */
  if (!CarApp_Init()) Error_Handler();

  /* USER CODE END 2 */

  /* Infinite loop */
  /* USER CODE BEGIN WHILE */
  while (1)
  {
    /* USER CODE END WHILE */

    /* USER CODE BEGIN 3 */
    CarApp_Loop();
    HAL_Delay(1);
  }
  /* USER CODE END 3 */
}

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
