xxiaolove8/engineering_innovation/docs/modules/line_sensor/reference/car_grayscale_sensor.h

#ifndef __GRAYSCALE_SENSOR_H
#define __GRAYSCALE_SENSOR_H

#include <stdint.h>
#include "AllHeader.h"
#include "delay.h"

//=====================================================================================
//  引脚配置接口 (Pin Configuration)
//=====================================================================================
// --- 通道选择引脚定义 (AD0, AD1, AD2)  Channel selection pin definition (AD0, AD1, AD2)---
#define SENSOR_AD0_PORT         GPIOF
#define SENSOR_AD0_PIN          GPIO_Pin_15

#define SENSOR_AD1_PORT         GPIOF
#define SENSOR_AD1_PIN          GPIO_Pin_14

#define SENSOR_AD2_PORT         GPIOF
#define SENSOR_AD2_PIN          GPIO_Pin_13

#define GrayS_OUT_PORT          GPIOG
#define GrayS_OUT_PIN           GPIO_Pin_0

//=====================================================================================
//  GPIO操作抽象接口 (GPIO Operation Macros)
//=====================================================================================
#define SENSOR_AD0_WRITE(state)  GPIO_WriteBit(SENSOR_AD0_PORT, SENSOR_AD0_PIN, (state) ? 1 : 0)
#define SENSOR_AD1_WRITE(state)  GPIO_WriteBit(SENSOR_AD1_PORT, SENSOR_AD1_PIN, (state) ? 1 : 0)
#define SENSOR_AD2_WRITE(state)  GPIO_WriteBit(SENSOR_AD2_PORT, SENSOR_AD2_PIN, (state) ? 1 : 0)

#define SENSOR_OUT_READ()        GPIO_ReadInputDataBit(GrayS_OUT_PORT, GrayS_OUT_PIN)

//=====================================================================================
//  驱动函数接口 (Driver API)
//=====================================================================================

#define GRAYSCALE_SENSOR_CHANNELS   8   // 传感器通道总数 Number of sensor channels

void Grayscale_Sensor_Init(void);
void Grayscale_Sensor_Read_All(uint16_t* sensor_values);
uint16_t Grayscale_Sensor_Read_Single(uint8_t channel);

#endif // __GRAYSCALE_SENSOR_H
