xxiaolove8/engineering_innovation/docs/modules/servo/reference/jdy31_f103_pwm.c

#include "stm32f10x.h"                  // Device header

void PWM_Init(void)
{
	RCC_APB1PeriphClockCmd(RCC_APB1Periph_TIM4, ENABLE); // PA7 TIM3 CH2
	RCC_APB2PeriphClockCmd(RCC_APB2Periph_GPIOB, ENABLE);
	
//	RCC_APB2PeriphClockCmd(RCC_APB2Periph_AFIO, ENABLE);
//	GPIO_PinRemapConfig(GPIO_PartialRemap1_TIM2, ENABLE);
//	GPIO_PinRemapConfig(GPIO_Remap_SWJ_JTAGDisable, ENABLE);
	
	GPIO_InitTypeDef GPIO_InitStructure;
	GPIO_InitStructure.GPIO_Mode = GPIO_Mode_AF_PP;
	GPIO_InitStructure.GPIO_Pin = GPIO_Pin_9;		//GPIO_Pin_15;
	GPIO_InitStructure.GPIO_Speed = GPIO_Speed_50MHz;
	GPIO_Init(GPIOB, &GPIO_InitStructure);
	
	TIM_InternalClockConfig(TIM4);
	
	TIM_TimeBaseInitTypeDef TIM_TimeBaseInitStructure;
	TIM_TimeBaseInitStructure.TIM_ClockDivision = TIM_CKD_DIV1;
	TIM_TimeBaseInitStructure.TIM_CounterMode = TIM_CounterMode_Up;
	TIM_TimeBaseInitStructure.TIM_Period = 20000 - 1;		//ARR
	TIM_TimeBaseInitStructure.TIM_Prescaler = 72 - 1;		//PSC
	TIM_TimeBaseInitStructure.TIM_RepetitionCounter = 0;
	TIM_TimeBaseInit(TIM4, &TIM_TimeBaseInitStructure);
	
	TIM_OCInitTypeDef TIM_OCInitStructure;
	TIM_OCStructInit(&TIM_OCInitStructure);
	TIM_OCInitStructure.TIM_OCMode = TIM_OCMode_PWM1;
	TIM_OCInitStructure.TIM_OCPolarity = TIM_OCPolarity_High;
	TIM_OCInitStructure.TIM_OutputState = TIM_OutputState_Enable;
	TIM_OCInitStructure.TIM_Pulse = 0;		//CCR
	TIM_OC4Init(TIM4, &TIM_OCInitStructure);
	TIM_OC4PreloadConfig(TIM4,TIM_OCPreload_Enable);
	TIM_ARRPreloadConfig(TIM4,ENABLE);
	TIM_Cmd(TIM4, ENABLE);
}

void PWM_SetCompare4(uint16_t Compare)
{
	TIM_SetCompare4(TIM4, Compare);
}
