xxiaolove8/engineering_innovation/host/ui.py

"""Tk views and visual widgets; communication lives in gui/session, never here."""

from collections import deque
import tkinter as tk
from tkinter import ttk

from .protocol import PID_NAMES

BG = "#eef3f8"
CARD = "#ffffff"
INK = "#172b43"
MUTED = "#718096"
ACCENT = "#0d9488"
BLUE = "#4285ed"
RED = "#d44b55"
FONT = "Microsoft YaHei UI"

PID_FIELDS = (
    ("比例 Kp", ""), ("积分 Ki", ""), ("微分 Kd", ""),
    ("比例 Kp", ""), ("积分 Ki", ""), ("微分 Kd", ""),
    ("基准目标速度", "计数 / 10 ms"), ("前馈 PWM", "‰"),
    ("转弯差速", "0–1"), ("弯道减速", "0–1"),
)


class ScrollPage(ttk.Frame):
    def __init__(self, parent):
        super().__init__(parent)
        self.canvas = tk.Canvas(self, bg=BG, highlightthickness=0, height=420)
        scroll = ttk.Scrollbar(self, command=self.canvas.yview)
        self.canvas.configure(yscrollcommand=scroll.set)
        scroll.pack(side="right", fill="y")
        self.canvas.pack(side="left", fill="both", expand=True)
        self.body = ttk.Frame(self.canvas, padding=(3, 14, 12, 10))
        item = self.canvas.create_window((0, 0), window=self.body, anchor="nw")
        self.body.bind("<Configure>", lambda _e: self.canvas.configure(scrollregion=self.canvas.bbox("all")))
        self.canvas.bind("<Configure>", lambda e: self.canvas.itemconfigure(item, width=e.width))


class SensorStrip(tk.Canvas):
    def __init__(self, parent):
        super().__init__(parent, height=110, bg=CARD, highlightthickness=0)
        self.bits = None
        self.bind("<Configure>", lambda _e: self.redraw())

    def redraw(self, bits=None, *, clear=False):
        if bits is not None or clear:
            self.bits = bits
        self.delete("all")
        width = max(self.winfo_width(), 400)
        step = (width - 40) / 8
        self.create_line(20, 43, width - 20, 43, fill="#e7eef5", width=8)
        for i in range(8):
            x = 20 + step * (i + .5)
            active = self.bits is not None and self.bits & (1 << i)
            self.create_oval(x-18, 25, x+18, 61, fill=ACCENT if active else "#e7eef5", outline="")
            self.create_text(x, 44, text="1" if active else "0" if self.bits is not None else "·",
                             fill="white" if active else MUTED, font=("Consolas", 12, "bold"))
            self.create_text(x, 82, text=f"CH{i+1}", fill=MUTED, font=(FONT, 9))


class SpeedChart(tk.Canvas):
    def __init__(self, parent):
        super().__init__(parent, height=130, bg=CARD, highlightthickness=0)
        self.samples = deque(maxlen=80)
        self.bind("<Configure>", lambda _e: self.redraw())

    def add(self, control):
        self.samples.append((control.left_measured, control.right_measured, control.left_target, control.right_target))
        self.redraw()

    def clear(self):
        self.samples.clear()
        self.redraw()

    def redraw(self):
        self.delete("all")
        w, h = max(self.winfo_width(), 400), max(self.winfo_height(), 130)
        for y in (20, 60, 100):
            self.create_line(34, y, w-12, y, fill="#e8eef5")
        if not self.samples:
            self.create_text(w/2, h/2, text="连接后显示轮速趋势", fill=MUTED, font=(FONT, 10))
            return
        maximum = max(1., *(max(sample) for sample in self.samples)) * 1.15
        self.create_text(16, 18, text=f"{maximum:.0f}", fill=MUTED, font=("Consolas", 8))
        self.create_text(18, h-18, text="0", fill=MUTED, font=("Consolas", 8))
        for series, color in ((2, "#afdcd6"), (3, "#c1d5fa"), (0, ACCENT), (1, BLUE)):
            points = []
            for i, sample in enumerate(self.samples):
                points.extend((34+i*(w-48)/79, h-20-max(0, sample[series])*(h-40)/maximum))
            if len(points) >= 4:
                self.create_line(*points, fill=color, width=2, dash=(4, 3) if series>1 else ())


class DashboardView:
    def __init__(self, app):
        self.app = app
        self.buttons = {}
        self.speed_charts = []
        self.scroll_pages = []
        self._style(app.root)
        self._build(app)

    @staticmethod
    def _style(root):
        root.configure(bg=BG)
        root.option_add("*Font", (FONT, 10))
        style = ttk.Style(root)
        style.theme_use("clam")
        style.configure(".", font=(FONT, 10), background=BG, foreground=INK)
        style.configure("TFrame", background=BG)
        style.configure("Card.TFrame", background=CARD)
        style.configure("TLabel", background=BG, foreground=INK)
        style.configure("Card.TLabel", background=CARD)
        style.configure("Muted.TLabel", background=CARD, foreground=MUTED, font=(FONT, 9))
        style.configure("Heading.TLabel", background=CARD, font=(FONT, 12, "bold"))
        style.configure("Metric.TLabel", background=CARD, foreground=INK, font=("Consolas", 23, "bold"))
        style.configure("TButton", background="#e7eef5", borderwidth=0, padding=(13, 8))
        style.map("TButton", background=[("active", "#dae5ef"), ("disabled", "#eff3f7")],
                  foreground=[("disabled", "#a6b3c1")])
        for name, color in (("Accent", ACCENT), ("Danger", RED)):
            style.configure(f"{name}.TButton", background=color, foreground="white", font=(FONT, 10, "bold"))
            style.map(f"{name}.TButton", background=[("disabled", "#d7e0e9"), ("active", color)],
                      foreground=[("disabled", "#8d9dac")])
        style.configure("TEntry", fieldbackground="#f7f9fc", padding=7, borderwidth=1)
        style.configure("TSpinbox", fieldbackground="#f7f9fc", padding=6)
        style.configure("TCombobox", fieldbackground="#f7f9fc", padding=6)
        style.map("TCombobox", fieldbackground=[("readonly", "#f7f9fc")])
        style.configure("TNotebook", background=BG, borderwidth=0, tabmargins=(0, 8, 0, 0))
        style.configure("TNotebook.Tab", padding=(22, 10), background=BG, foreground=MUTED)
        style.map("TNotebook.Tab", background=[("selected", CARD)], foreground=[("selected", ACCENT)])
        style.configure("TCheckbutton", background=CARD)

    def card(self, parent, title, subtitle=None):
        frame = ttk.Frame(parent, style="Card.TFrame", padding=18)
        ttk.Label(frame, text=title, style="Heading.TLabel").pack(anchor="w")
        if subtitle:
            ttk.Label(frame, text=subtitle, style="Muted.TLabel", wraplength=650).pack(anchor="w", pady=(4, 12))
        return frame
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
