xxiaolove8/engineering_innovation/(commit log)

2026-09-23 第一版AI生成的代码，包括联调
2026-09-23 第一版AI生成的代码，包括联调 未进行管理的文件更新
    [pinout.csv]
2026-10-06 整理 if_car 完整源码、上位机与技术报告参考资料
    纳入固件控制、PID 与舵机 Flash 参数、串口上位机、测试、引脚配置、模块手册和历史联调文档。保留手写诊断脚本及参考源码原始字节，排除构建输出、运行日志、测量结果、虚拟环境和缓存。
    [STM32F407最小系统板IO分配表.xlsx, board_pinout.csv, legacy_pinout.csv, pinout.csv]
